koshinoya/Keyboards/rect44/data/dxf_jp.md

## Rect44_SWP_003.dxf
トッププレート兼ケースで使用しているステンレス板金曲げのDXF(AutoCAD 2000形式)データ。  
材質は SUS304 t1.5 HL(ヘアライン仕上げ)、ヘアライン方向は長手。この表面仕上げは指紋が目立ちにくいのでキーボードに向いていると思う。試作で作るなら安い2B(No.2B)仕上げでも良いが、曲げ加工時の跡が目立ちやすい。

板金曲げは加工時に金属が多少延びるので、仕上がり寸法だけ指示して切り出し寸法は業者さん任せ。多分曲げ加工機のクセなどもあるはずなのでここは実際に加工する人にお願いする。
スイッチがはまる部分の寸法は図面データをそのままレーザー加工機の加工データに流用するので1/100mmの精度で作図して渡した。

板金曲げには様々な加工上の制限があるので、とりあえず欲しい形状の図面を書いて業者さんとの相談になる。Rect44の場合はコストダウンのために比較的単純な形状とした。

このケースは遠松製作所[(http://www.tomatsu-ss.co.jp/)](http://www.tomatsu-ss.co.jp/)さんで製作してもらいました。
