koshinoya/Keyboards/rect44/img/bmp_07.jpg

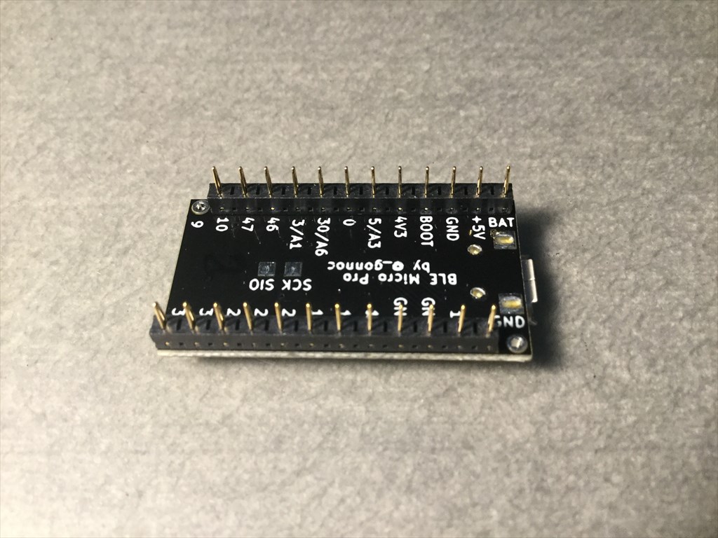
rect44/img/bmp_07.jpg
