koshinoya/Keyboards/rect44/img/diode_02.jpg

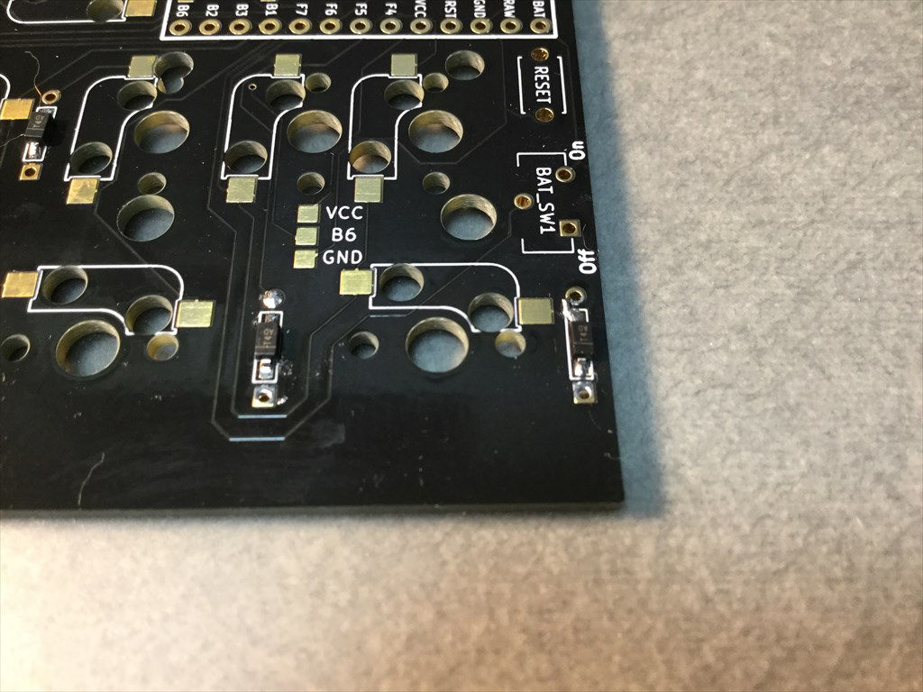
rect44/img/diode_02.jpg
