koshinoya/Keyboards/rect44/img/rect44_01.jpg

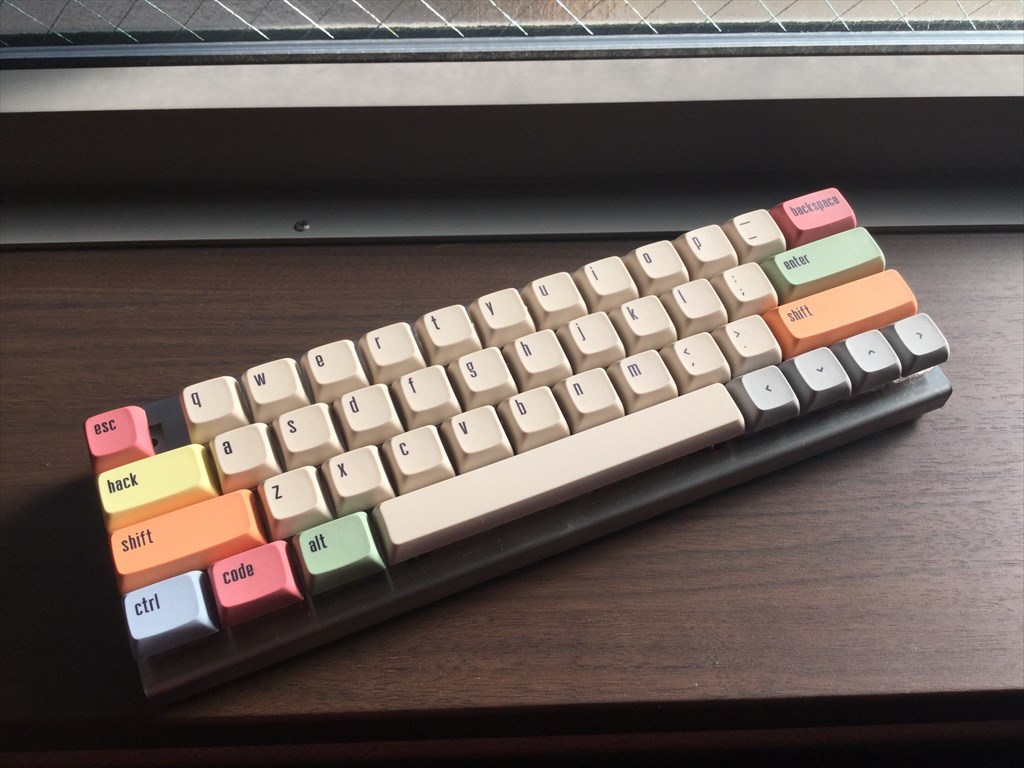
rect44/img/rect44_01.jpg
