koshinoya/Keyboards/rect44/img/sbd_02.jpg

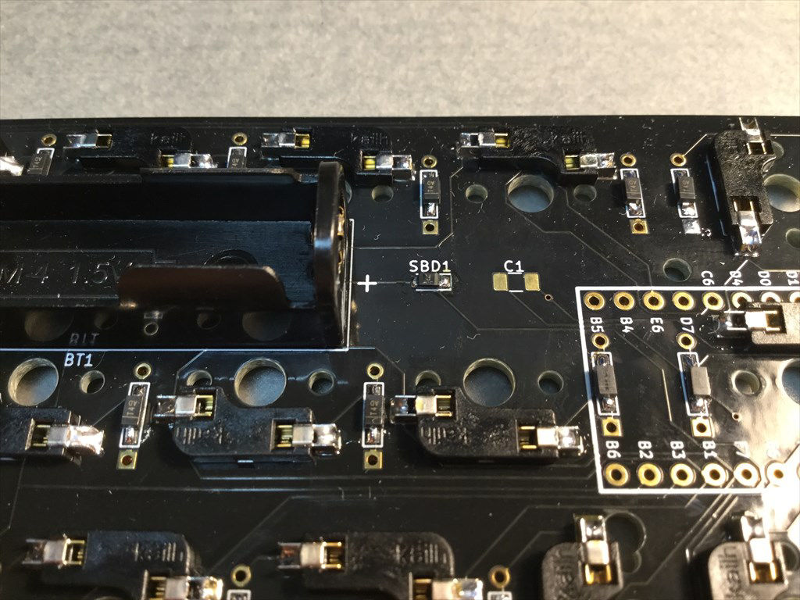
rect44/img/sbd_02.jpg
