koshinoya/Keyboards/rect44/img/socket_02.jpg

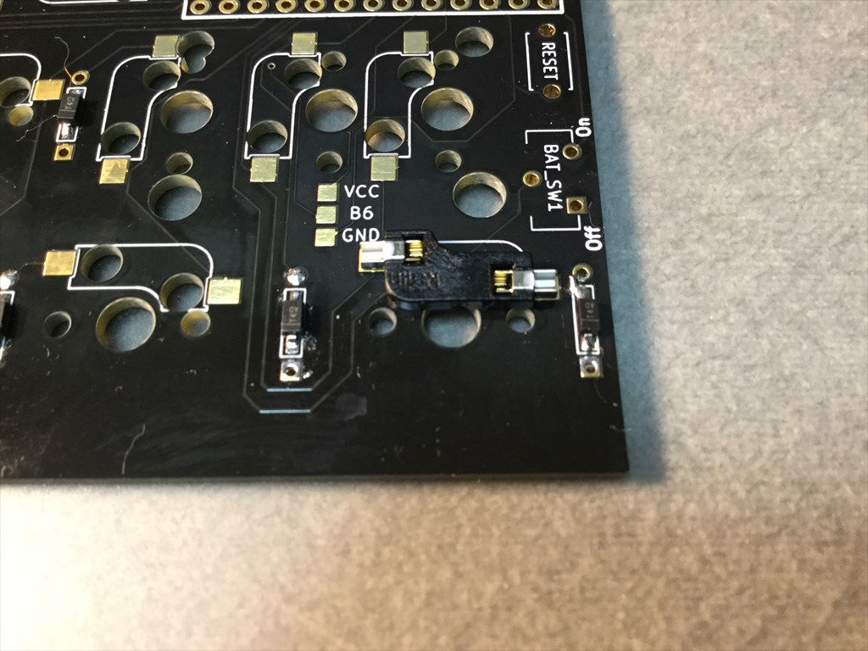
rect44/img/socket_02.jpg
