koshinoya/Keyboards/susp46/Plate/SUSp46_TopPlate v2.step

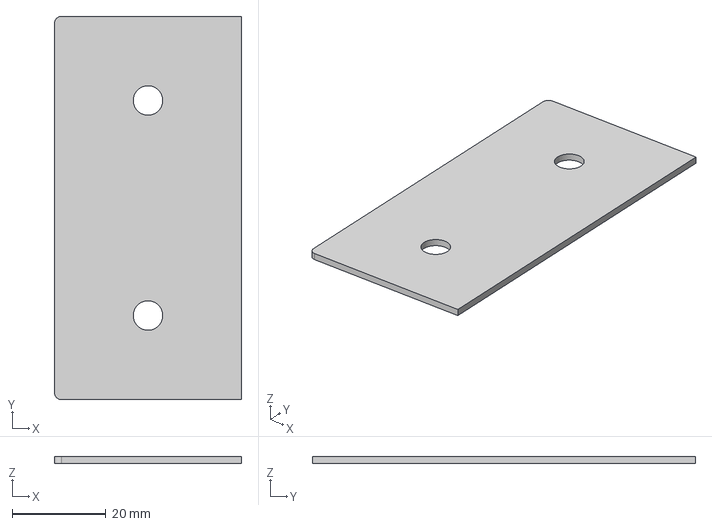
[picture p6: CAD file, 2024-05-05]
susp46/Plate/SUSp46_TopPlate v2.step
40.0 x 82.0 x 1.50 mm
