koshinoya/Keyboards/susp46/Plate/SUSp46_SwitchPlate.dxf

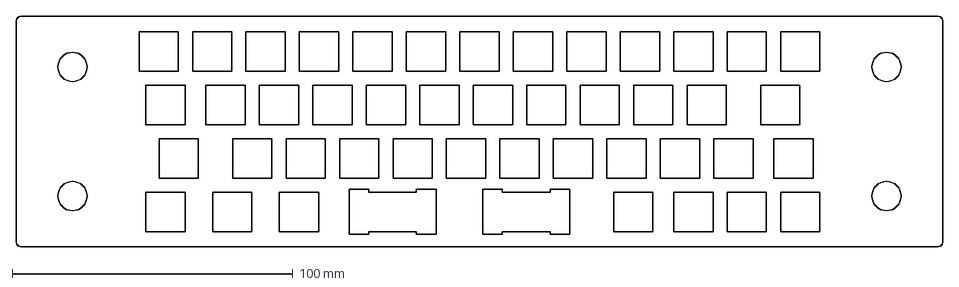
[picture p7: CAD file, 2024-05-05]
susp46/Plate/SUSp46_SwitchPlate.dxf
330.0 x 82.0 mm
