koshinoya/Keyboards/susp46/Plate/SUSp46_SwitchPlate v1.step

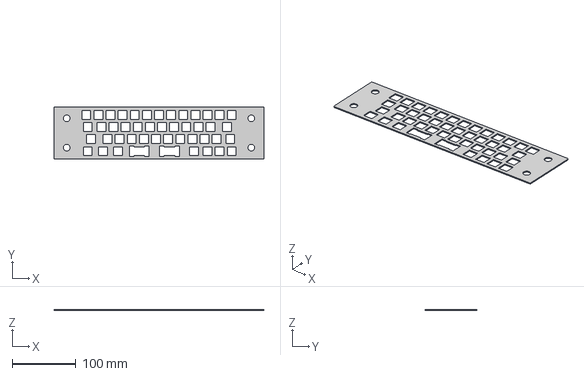
[picture p8: CAD file, 2024-05-05]
susp46/Plate/SUSp46_SwitchPlate v1.step
330.0 x 82.0 x 1.50 mm
