koshinoya/Keyboards/susp46/Plate/SUSp46_BottomPlate v3.step

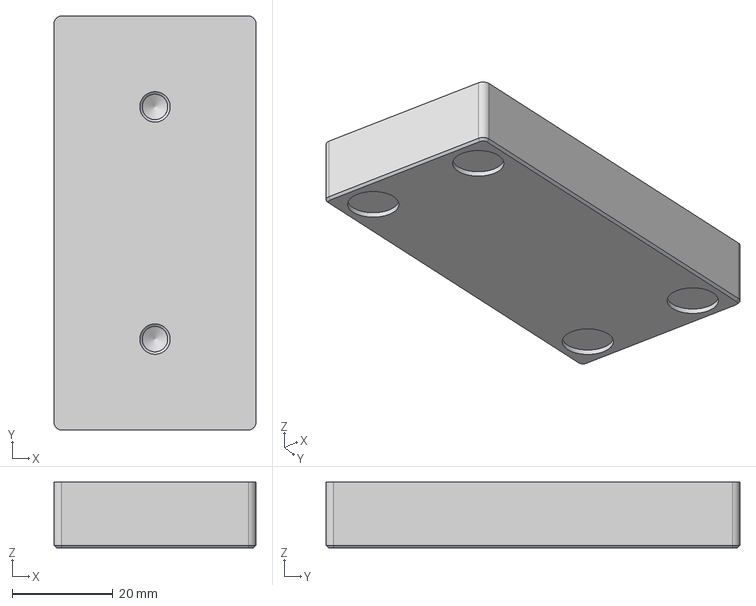
[picture p9: CAD file, 2024-05-05]
susp46/Plate/SUSp46_BottomPlate v3.step
40.0 x 82.0 x 13.0 mm
