koshinoya/Keyboards/(list of files, cad)

Other CAD files:
rect44/data/Rect44_SWP_003.dxf
