koshinoya/Keyboards/susp46/PCB-KiCad/Susp46_sch.pdf

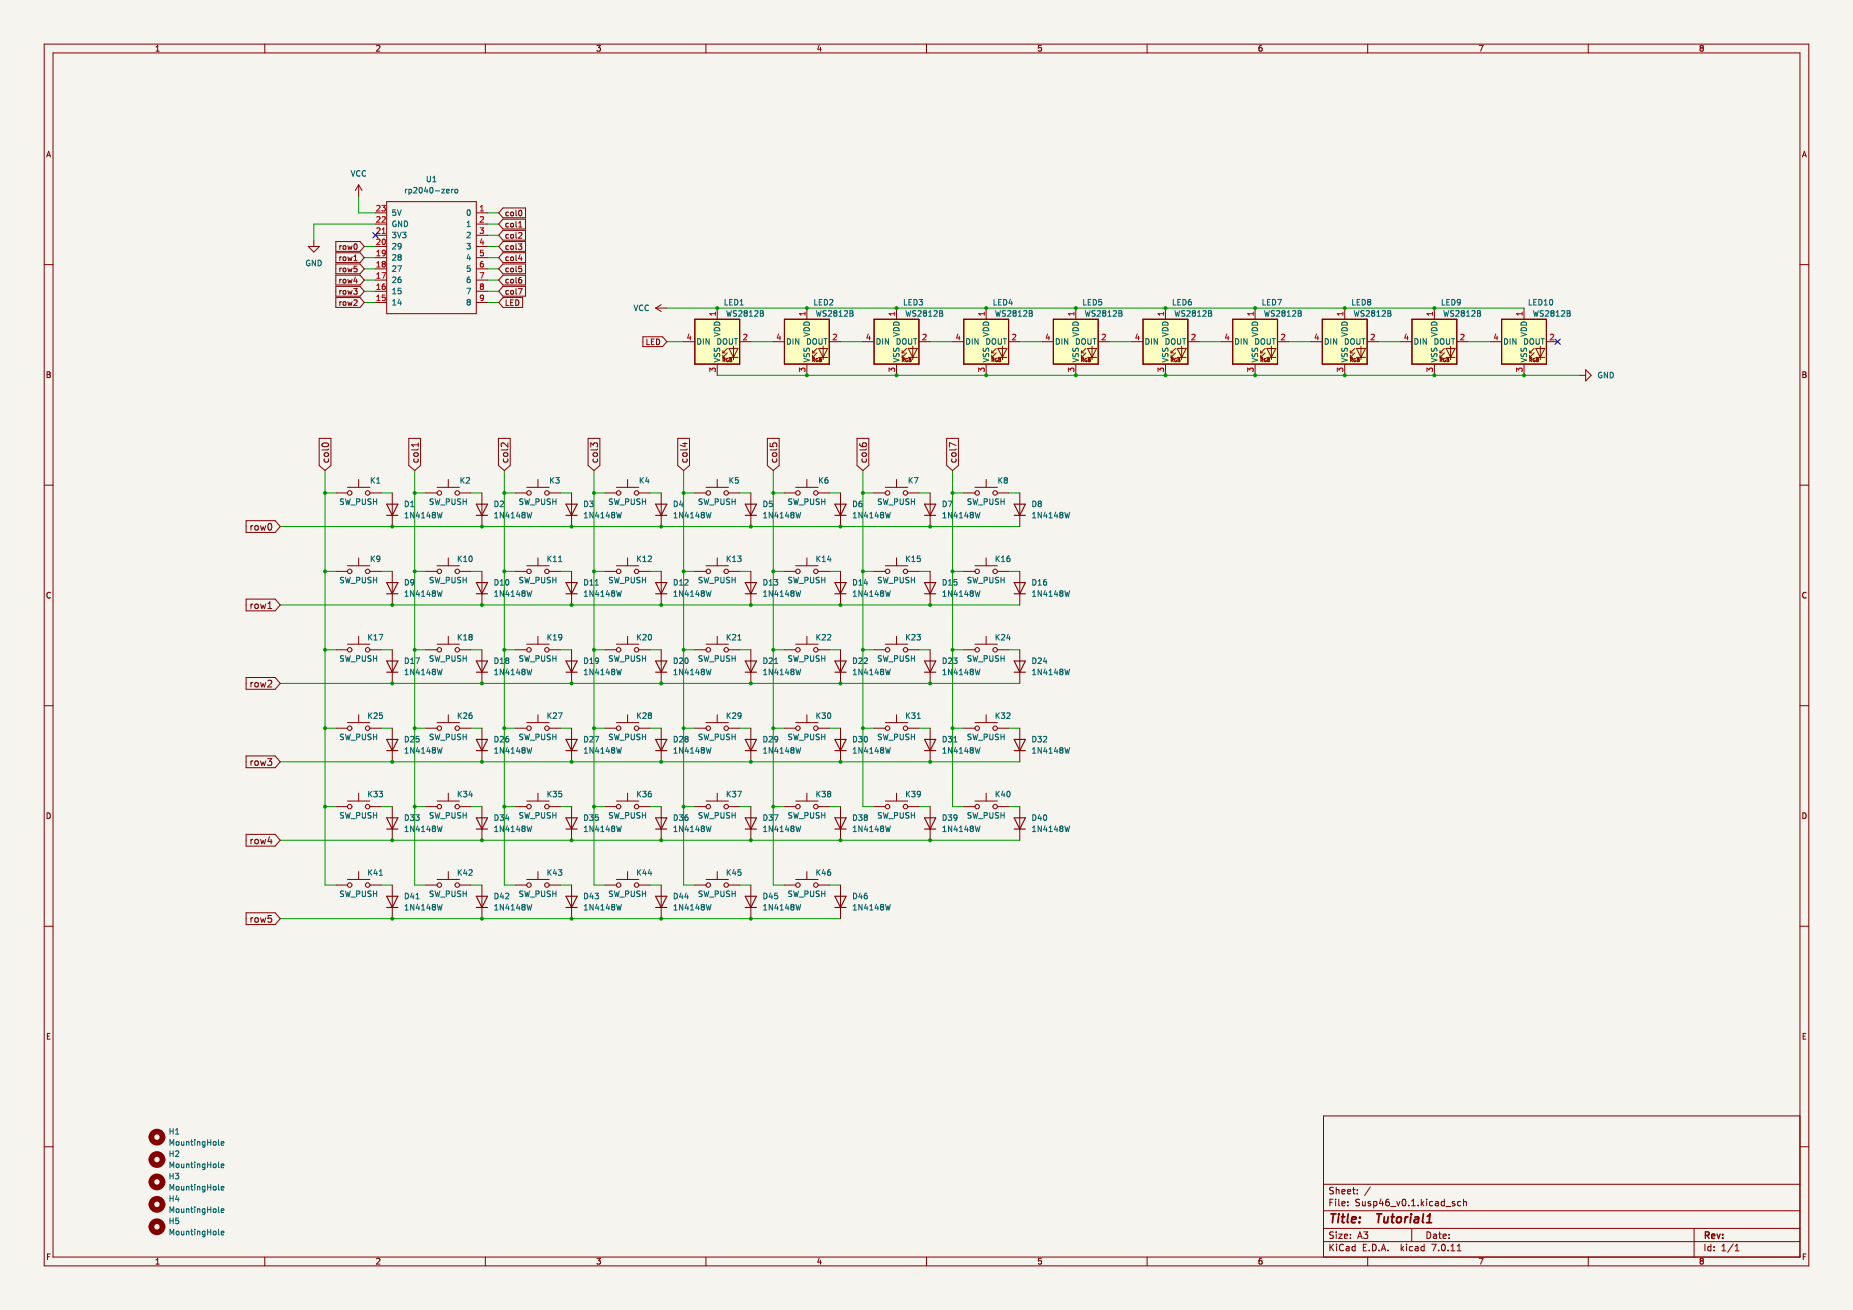
[picture p64: page 1]
