koshinoya/Keyboards/susp46/PCB-KiCad/Susp46_v0.1.kicad_pcb

## KiCad design susp46/PCB-KiCad/Susp46_v0.1.kicad_pcb (2024-05-05)

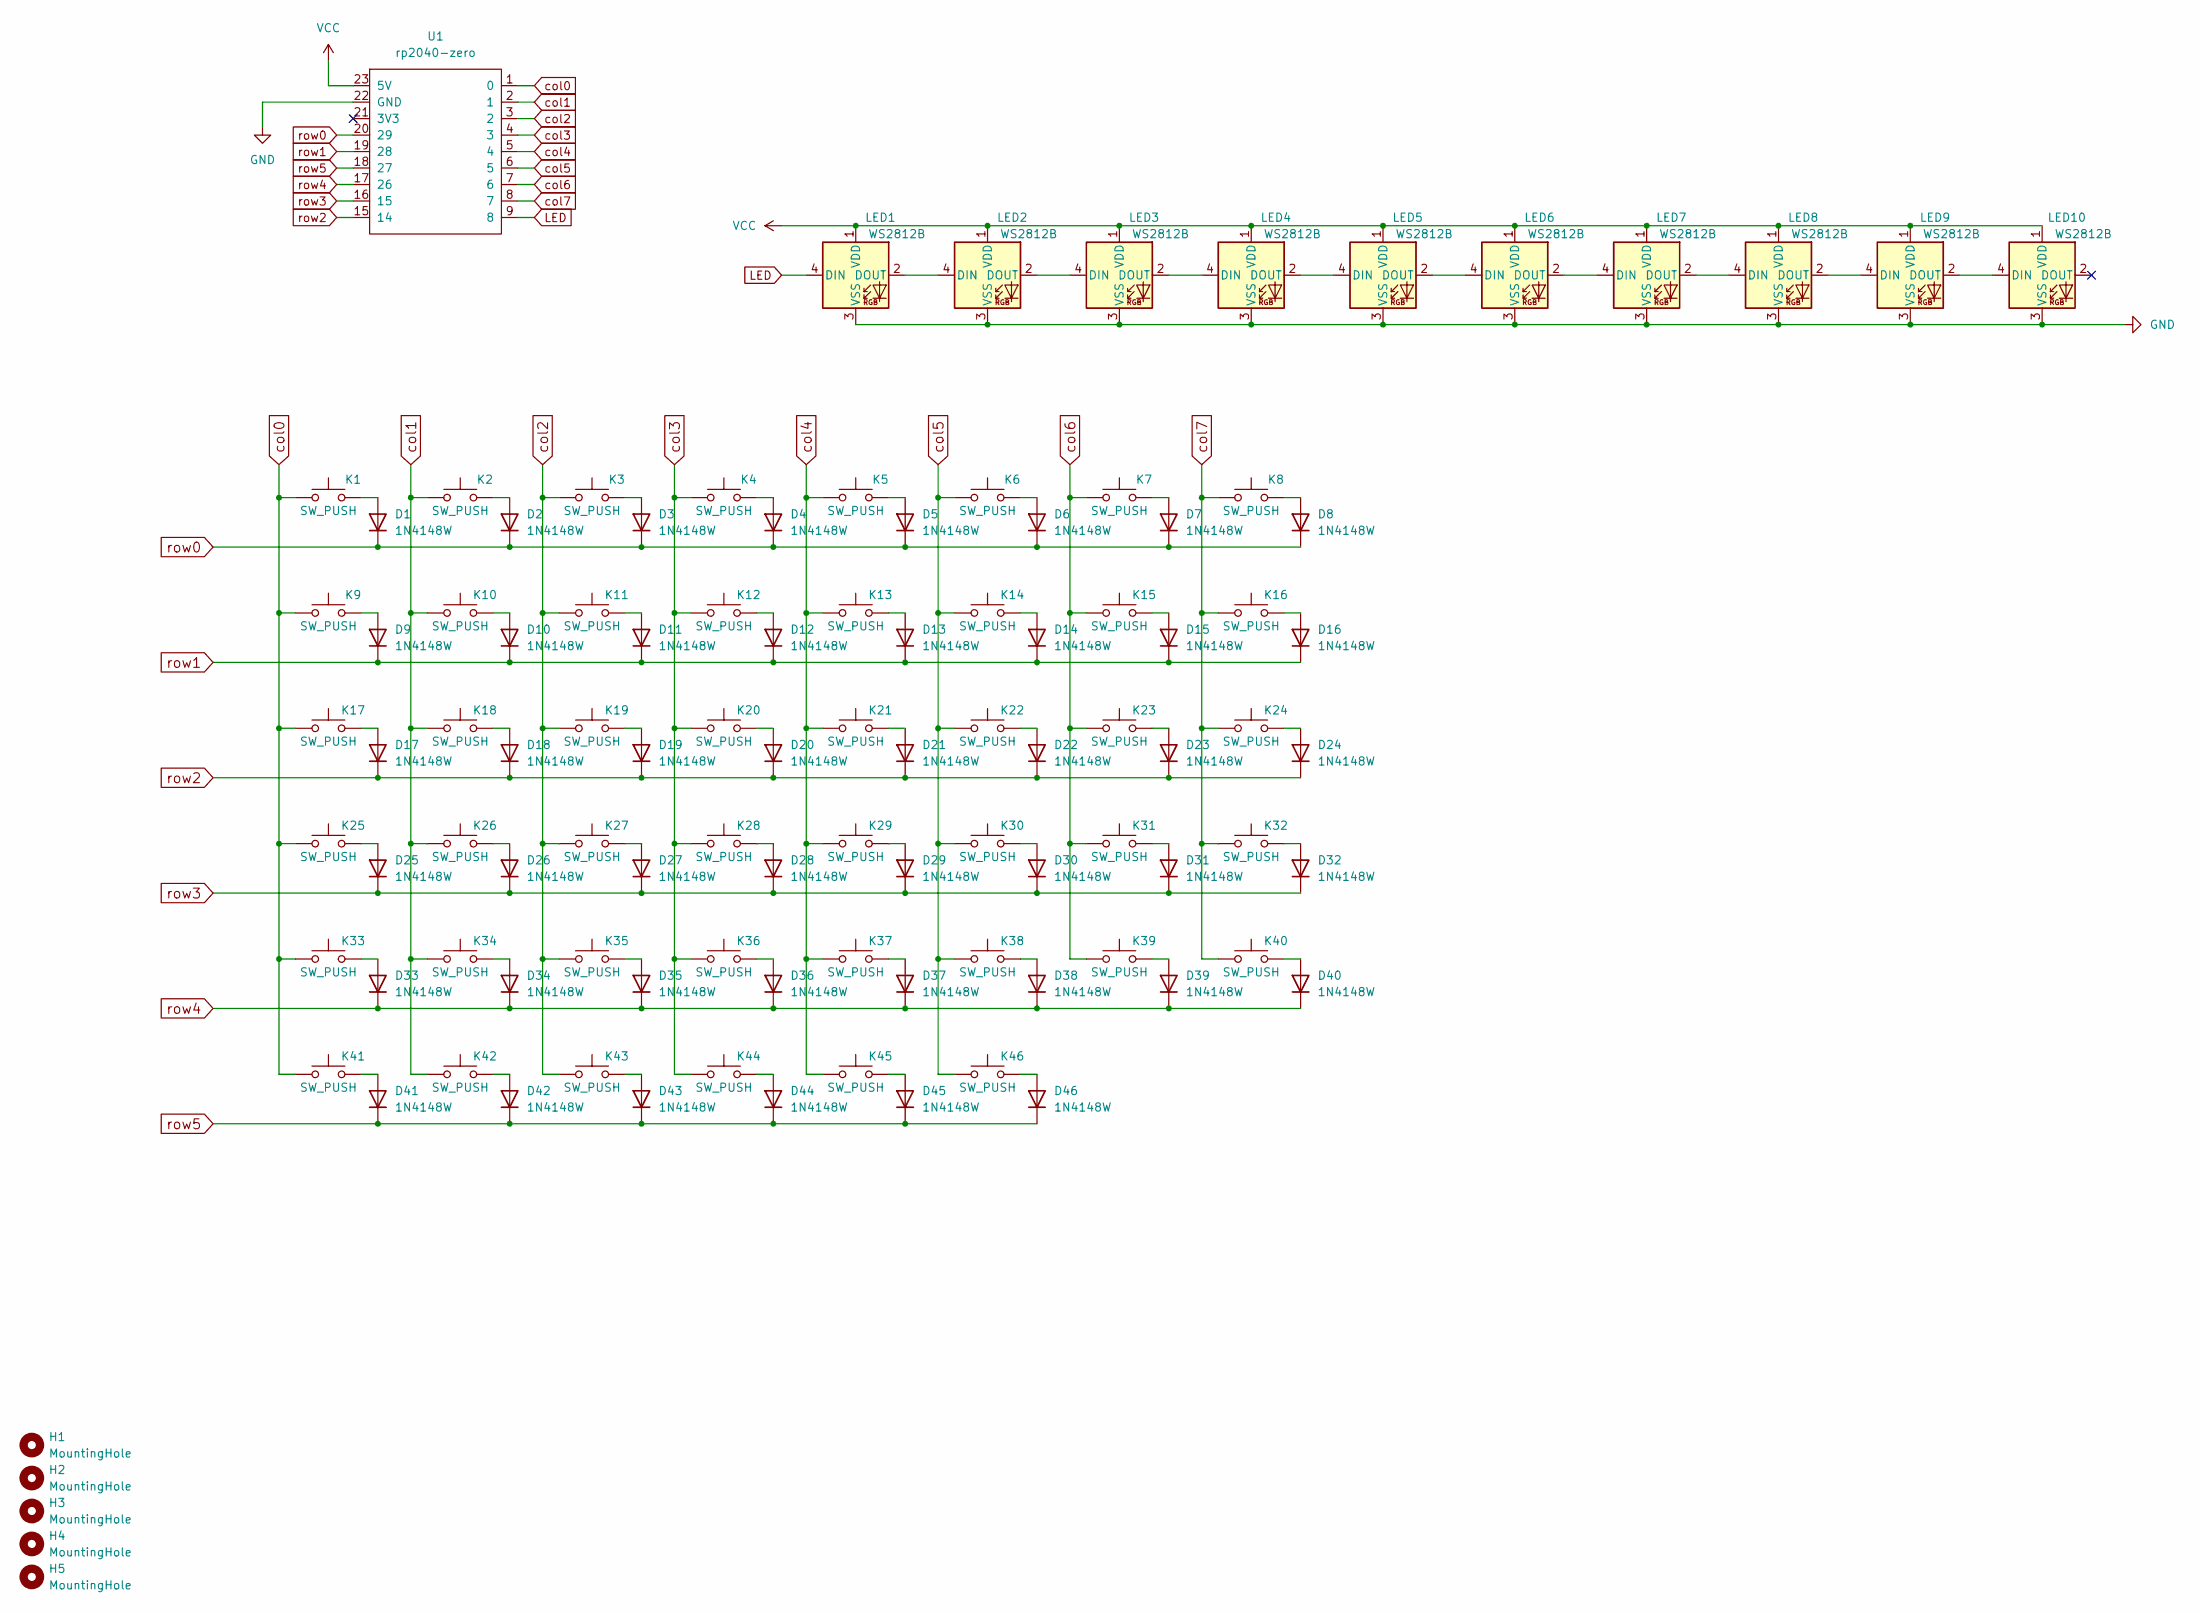
[picture p65: schematic Susp46_v0.1.kicad_sch, Tutorial1]

Parts:
D1, D2, D3, D4, D5, D6, D7, D8, D9, D10, D11, D12, D13, D14, D15, D16, D17, D18, D19, D20, D21, D22, D23, D24, D25, D26, D27, D28, D29, D30, D31, D32, D33, D34, D35, D36, D37, D38, D39, D40, D41, D42, D43, D44, D45, D46: 1N4148W; D_SOD-123
H1, H2, H3, H4, H5: MountingHole; MountingHole_2.2mm_M2_Pad_TopBottom
K1, K2, K3, K4, K5, K6, K7, K8, K9, K10, K11, K12, K13, K15, K16, K17, K18, K19, K20, K21, K22, K23, K24, K27, K28, K29, K30, K31, K32, K33, K34, K35, K36, K44, K45, K46: SW_PUSH; SW_Cherry_MX_1.00u_PCB
K14, K37, K38, K39, K40, K43: SW_PUSH; SW_Cherry_MX_1.25u_PCB
K25, K26: SW_PUSH; SW_Cherry_MX_1.75u_PCB
K41: SW_PUSH; SW_Cherry_MX_2.25u_PCB
K42: SW_PUSH; SW_Cherry_MX_2.75u_PCB
LED1, LED2, LED3, LED4, LED5, LED6, LED7, LED8, LED9, LED10: WS2812B; LED_WS2812B_PLCC4_5.0x5.0mm_P3.2mm
U1: rp2040-zero; rp2040-zero-tht-5Pads-Less

Connections:
GND: LED1.3 (VSS), LED2.3 (VSS), LED3.3 (VSS), LED4.3 (VSS), LED5.3 (VSS), LED6.3 (VSS), LED7.3 (VSS), LED8.3 (VSS), LED9.3 (VSS), LED10.3 (VSS), U1.22 (GND)
LED: LED1.4 (DIN), U1.9 (8)
unnamed: D1.2 (A), K1.2
unnamed: D2.2 (A), K2.2
unnamed: D3.2 (A), K3.2
unnamed: D4.2 (A), K4.2
unnamed: D5.2 (A), K5.2
unnamed: D6.2 (A), K6.2
unnamed: D7.2 (A), K7.2
unnamed: D8.2 (A), K8.2
unnamed: D9.2 (A), K9.2
unnamed: D10.2 (A), K10.2
unnamed: D11.2 (A), K11.2
unnamed: D12.2 (A), K12.2
unnamed: D13.2 (A), K13.2
unnamed: D14.2 (A), K14.2
unnamed: D15.2 (A), K15.2
unnamed: D16.2 (A), K16.2
unnamed: D17.2 (A), K17.2
unnamed: D18.2 (A), K18.2
unnamed: D19.2 (A), K19.2
unnamed: D20.2 (A), K20.2
unnamed: D21.2 (A), K21.2
unnamed: D22.2 (A), K22.2
unnamed: D23.2 (A), K23.2
unnamed: D24.2 (A), K24.2
unnamed: D25.2 (A), K25.2
unnamed: D26.2 (A), K26.2
unnamed: D27.2 (A), K27.2
unnamed: D28.2 (A), K28.2
unnamed: D29.2 (A), K29.2
unnamed: D30.2 (A), K30.2
unnamed: D31.2 (A), K31.2
unnamed: D32.2 (A), K32.2
unnamed: D33.2 (A), K33.2
unnamed: D34.2 (A), K34.2
unnamed: D35.2 (A), K35.2
unnamed: D36.2 (A), K36.2
unnamed: D37.2 (A), K37.2
unnamed: D38.2 (A), K38.2
unnamed: D39.2 (A), K39.2
unnamed: D40.2 (A), K40.2
unnamed: D41.2 (A), K41.2
unnamed: D42.2 (A), K42.2
unnamed: D43.2 (A), K43.2
unnamed: D44.2 (A), K44.2
unnamed: D45.2 (A), K45.2
unnamed: D46.2 (A), K46.2
unnamed: LED1.2 (DOUT), LED2.4 (DIN)
unnamed: LED2.2 (DOUT), LED3.4 (DIN)
unnamed: LED3.2 (DOUT), LED4.4 (DIN)
unnamed: LED4.2 (DOUT), LED5.4 (DIN)
unnamed: LED5.2 (DOUT), LED6.4 (DIN)
unnamed: LED6.2 (DOUT), LED7.4 (DIN)
unnamed: LED7.2 (DOUT), LED8.4 (DIN)
unnamed: LED8.2 (DOUT), LED9.4 (DIN)
unnamed: LED9.2 (DOUT), LED10.4 (DIN)
VCC: LED1.1 (VDD), LED2.1 (VDD), LED3.1 (VDD), LED4.1 (VDD), LED5.1 (VDD), LED6.1 (VDD), LED7.1 (VDD), LED8.1 (VDD), LED9.1 (VDD), LED10.1 (VDD), U1.23 (5V)
col0: K1.1, K9.1, K17.1, K25.1, K33.1, K41.1, U1.1 (0)
col1: K2.1, K10.1, K18.1, K26.1, K34.1, K42.1, U1.2 (1)
col2: K3.1, K11.1, K19.1, K27.1, K35.1, K43.1, U1.3 (2)
col3: K4.1, K12.1, K20.1, K28.1, K36.1, K44.1, U1.4 (3)
col4: K5.1, K13.1, K21.1, K29.1, K37.1, K45.1, U1.5 (4)
col5: K6.1, K14.1, K22.1, K30.1, K38.1, K46.1, U1.6 (5)
col6: K7.1, K15.1, K23.1, K31.1, K39.1, U1.7 (6)
col7: K8.1, K16.1, K24.1, K32.1, K40.1, U1.8 (7)
row0: D1.1 (K), D2.1 (K), D3.1 (K), D4.1 (K), D5.1 (K), D6.1 (K), D7.1 (K), D8.1 (K), U1.20 (29)
row1: D9.1 (K), D10.1 (K), D11.1 (K), D12.1 (K), D13.1 (K), D14.1 (K), D15.1 (K), D16.1 (K), U1.19 (28)
row2: D17.1 (K), D18.1 (K), D19.1 (K), D20.1 (K), D21.1 (K), D22.1 (K), D23.1 (K), D24.1 (K), U1.15 (14)
row3: D25.1 (K), D26.1 (K), D27.1 (K), D28.1 (K), D29.1 (K), D30.1 (K), D31.1 (K), D32.1 (K), U1.16 (15)
row4: D33.1 (K), D34.1 (K), D35.1 (K), D36.1 (K), D37.1 (K), D38.1 (K), D39.1 (K), D40.1 (K), U1.17 (26)
row5: D41.1 (K), D42.1 (K), D43.1 (K), D44.1 (K), D45.1 (K), D46.1 (K), U1.18 (27)

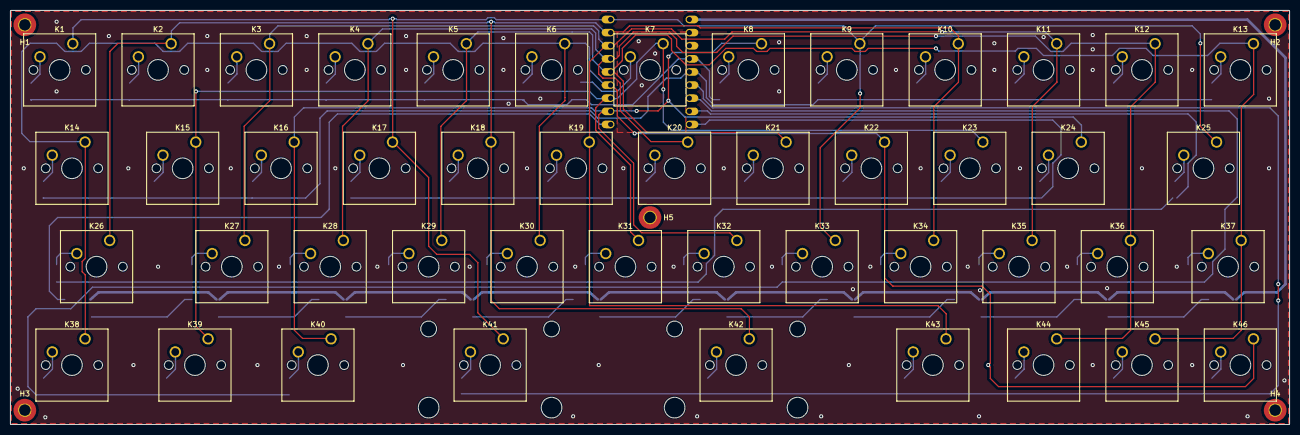
[picture p66: board Susp46_v0.1.kicad_pcb from above]

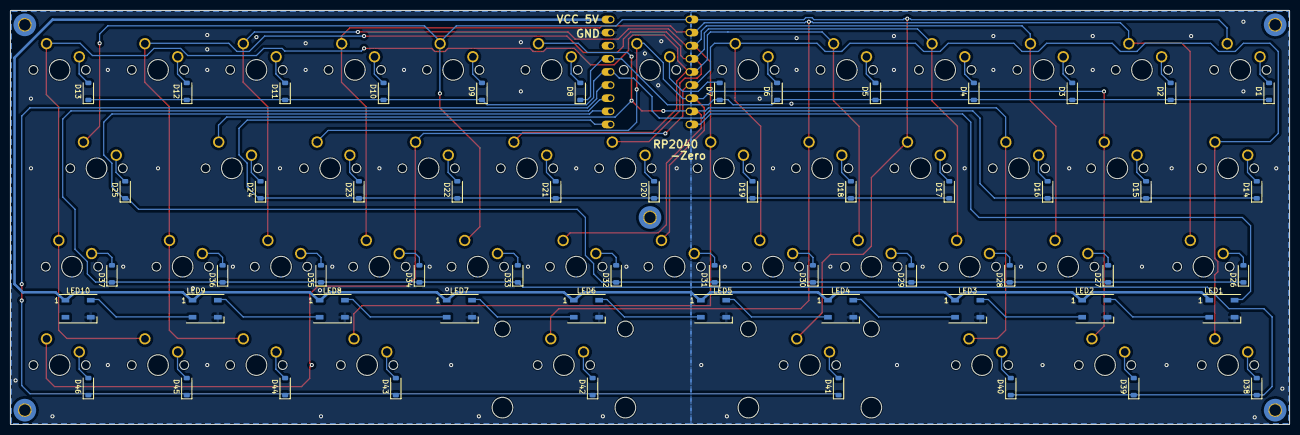
[picture p67: board Susp46_v0.1.kicad_pcb from below]

Board: 2 copper layers, 247.7 x 80.2 mm, 108 parts (56 on the bottom side), 72 nets.
