koshinoya/Keyboards/(commit log)

2020-05-05 Upload DXF data of Rect44 case
    [Rect44_SWP_003.dxf]
2020-05-14 Update dxf data and upload def_jp.md
    [Rect44_SWP_003.dxf]
2022-01-23 Add PCB support
    Upload Rect44_build_guide_jp_v1.2.2.md and jpg files.
2024-05-05 Add susp46
    [SUSp46_BottomPlate v3.step, SUSp46_SwitchPlate v1.step, SUSp46_SwitchPlate.dxf, SUSp46_TopPlate v2.step, Susp46_v0.1.kicad_pcb, Susp46_v0.1.kicad_sch]
